hodza101/Maturski/viber_slika_2026-05-03_19-04-42-335.jpg

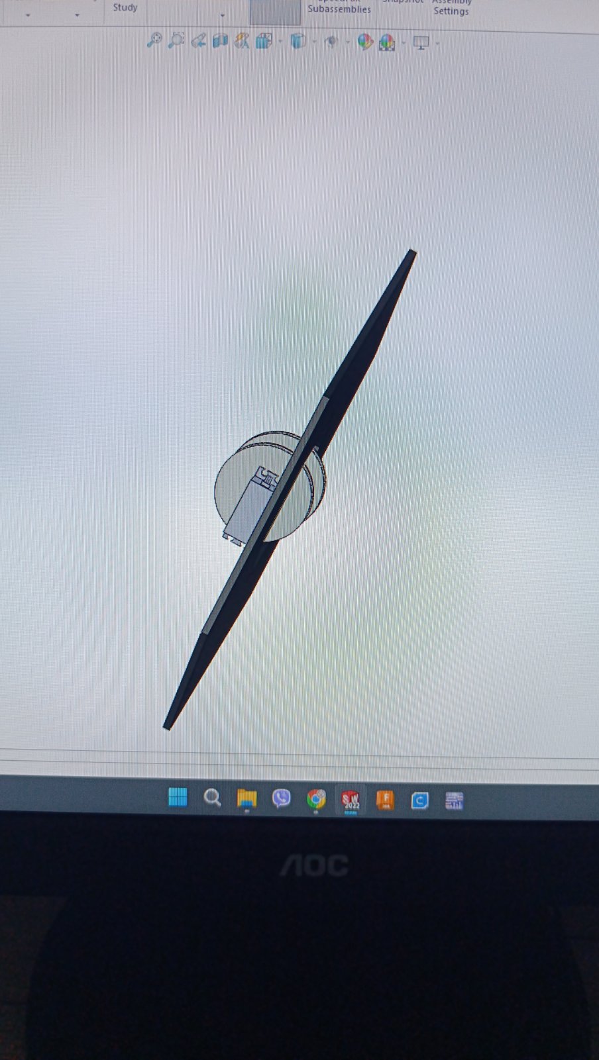
viber_slika_2026-05-03_19-04-42-335.jpg
