hodza101/Maturski/SpiRob_Grappler_Maturski_rad_v4_profesionalno.docx

JU MJEŠOVITA SREDNJA ELEKTROTEHNIČKA ŠKOLA TUZLA

MATURSKI RAD

Projektovanje i izrada modularnog kabelskog grapplera

sa šest fleksibilnih robotskih ruku

SpiRob Grappler — STM32 Mission Control

Predmet: | Maturski rad
Tema: | Projektovanje i izrada modularnog kabelskog grapplera sa šest fleksibilnih robotskih ruku
Učenici: | Edin Hodžić i Kenan Muhamedbegović
Mentor: | mr. sci. Muamer Halilović, dipl. ing. el.
Mjesto i datum: | Tuzla, maj 2026. godine

Radna dokumentacija sa hardverskim, softverskim i CAD/STL prilozima

# Sadržaj

# 1. Uvod

Maturski rad pod naslovom 'Projektovanje i izrada modularnog kabelskog grapplera sa šest fleksibilnih robotskih ruku' opisuje razvoj složenog mehatroničkog sistema koji objedinjuje mehaničko projektovanje, 3D/CAD modeliranje, elektroniku, ugrađeno programiranje, Bluetooth komunikaciju i razvoj korisničkih aplikacija. Upravljačka jedinica završne verzije sistema je mikrokontroler STM32F103C8T6, dok se za bežični prenos komandi koristi HC-06 Bluetooth modul.

Osnovna ideja projekta zasniva se na raspoređivanju šest fleksibilnih ruku oko heksagonalnog kućišta. Pokret svake ruke ostvaruje se povlačenjem sajli koje prolaze kroz kanale na platformama i navijaju se oko servo diskova. Ovakav kabelski pogon omogućava da motori budu smješteni na stabilnoj nosećoj platformi, dok se sila prenosi do krajeva ruku putem lakih i fleksibilnih sajli. Time se minimizuje masa pokretnih dijelova i bitno pojednostavljuje mehanička konstrukcija.

U dokumentaciji su obrađeni sljedeći aspekti: teorijska osnova i inspiracija iz naučne literature, izbor materijala i postupak konstruisanja, raspored rupa za sajle i opis CAD/STL rješenja, električno spajanje komponenti, komunikacioni protokol, STM32 upravljački program, desktop aplikacija app5.py, mobilna Android aplikacija, postupak instalacije i pokretanja, testiranje sistema, sigurnosne napomene i prijedlozi za buduća poboljšanja. Cilj je da dokumentacija bude dovoljno precizna i potpuna da se projekat može neovisno rekonstruisati, testirati i nadograditi.

# 2. Teorijska osnova i inspiracija iz literature

## 2.1. Logaritamska spirala i kabelski pogon

Inspiracija za ovaj projekat dolazi iz koncepta SpiRobs robotskih struktura, kod kojih se oblik i način kretanja zasnivaju na principu logaritamske spirale. U referentnoj literaturi navodi se da mnogi biološki nastavci — rep kameleona, rep morskog konjica, krak hobotnice i surla slona — ispoljavaju spiralne oblike koji omogućavaju hvatanje, obavijanje i manipulaciju objektima. Ovaj biološki princip prenosi se na robote tako što se tijelo gradi od modularnih segmenata sposobnih da se savijaju u spiralnu konfiguraciju.

Za potrebe ovog maturskog rada cilj nije bio matematički potpuno reproducirati sve modele iz literature, nego iskoristiti temeljni princip modularnog, kabelski pokretanog hvatača. U kabelskom pogonu motor rotira servo disk koji navija sajlu, a sajla prenosi silu do fleksibilne ruke izazivajući njeno savijanje. U praktičnoj primjeni ključni su faktori: minimizacija trenja u vodilicama, precizno poravnanje rupa za sajle te dovoljna mehanička čvrstoća nosača servo motora.

Odabir konfiguracije sa šest ruku zasniva se na nalazima iz literature koja pokazuje da višeručni raspored značajno povećava vjerovatnoću uspješnog obuhvatanja objekta sa više strana. Rezultati eksperimenata sa multi-SpiRob konfiguracijama pokazali su da šest ruku pruža visok postotak uspješnosti hvatanja u poređenju s konfiguracijama s manjim brojem ruku. Takav raspored je, dakle, i mehanički i funkcionalno opravdan.

## 2.2. Dopuna iz eksperimentalnih procedura

Dodatni materijali koji prate SpiRobs rad sadrže praktične smjernice vezane uz izradu prototipa. Tijelo robota preporučuje se štampati od TPU (termoplastičnog poliuretana) materijala. Pri tome treba pažljivo odabrati tvrdoću filamenta jer različite tvrdoće direktno utječu na krutost i elastičnost ruke. U navedenoj literaturi navodi se TPU 95A kao dobar kompromis između fleksibilnosti i pouzdane 3D štampe.

Posebno je istaknuto da TPU filament mora biti temeljno osušen prije štampe. Prisustvo vlage u filamentu uzrokuje pojavu tzv. stringa (neželjenih niti između dijelova), curenje materijala i neuredan prototip. Također se preporučuje izbjegavati sisteme s ekstruderom koji stvaraju visoko trenje pri dovodu materijala, te koristiti sisteme s direktnim dovodom filamenta kako bi se osigurao stabilan tok.

Za sajle se u literaturi preporučuje UHMWPE (ultra-high-molecular-weight polyethylene) sajla promjera oko 0,5 mm. Ovaj materijal je odabran zbog male mase, visoke čvrstoće i minimalnog istezanja pod opterećenjem. U ovom projektu ta vrsta sajle navedena je kao preporučeni izbor za buduću verziju rukavaca, dok su rupe na platformama predviđene s većim promjerom od 2 mm kako bi se osigurale tolerancija štampe i mogućnost ugradnje vodilica.

Tabela 1. Prenos preporuka iz literature na praktičnu izvedbu projekta.

Izvorna preporuka iz literature | Primjena u ovom projektu
TPU za fleksibilne dijelove | Fleksibilne ruke ili segmenti štampaju se od TPU filamenta.
TPU mora biti suh | Filament se temeljno suši prije štampe radi urednih rubova i stabilnog prototipa.
UHMWPE sajla ≈ 0,5 mm | Sajla za prenos sile; rupe na platformi iznose ø2 mm radi tolerancije.
Čelična žica kao igla za uvlačenje | Koristi se pri provlačenju sajle kroz duže ili uže kanale.
Kabelski pogon s 2–3 sajle po ruci | Svaka od šest ruku ima tri rupice za sajle raspoređene u obliku trougla.

# 3. Zahtjevi projekta

Projektni zahtjevi definirani su tokom višestrukih iteracija izrade prototipa te razvoja desktop i mobilne aplikacije. Prvobitno je sistem razmatran s pločom Arduino Uno, no završna verzija dokumentacije i koda prebačena je na STM32F103C8T6. Ova promjena je važna jer podrazumijeva novo mapiranje pinova, drugačije logičke nivoe (3,3 V umjesto 5 V), izmijenjeni naziv hardverske mape u aplikaciji i drugačiji postupak programiranja kontrolera.

Tabela 2. Sažetak osnovnih zahtjeva projekta.

Kategorija | Zahtjev
Mehanika | Heksagonalno kućište s donjom platformom, servo platformom i bočnim stranicama.
Broj ruku | Šest pozicija za ruke, ravnomjerno raspoređenih po heksagonu.
Rupe za sajle | Tri rupe po ruci, promjera 2 mm, raspoređene u obliku trougla.
Razmak platformi | Razmak između donje i srednje platforme iznosi 3 cm.
Aktuatori | Dva servo motora s čvrstim nosačima i servo diskovima.
Kontroler | STM32F103C8T6 — UART za Bluetooth, PWM za servo pogon.
Softver | Desktop aplikacija app5.py i Android aplikacija za mobilni telefon.
Sigurnost | E-STOP komanda mora uvijek biti lako dostupna i vidljiva u sučelju.

Pored funkcionalnih zahtjeva, važan kriterij je i prezentabilnost cjelokupnog sistema: aplikacija mora izgledati profesionalno, dokumentacija mora biti uredno formatirana, a dijagrami trebaju jasno i nedvosmisleno prikazati ono što je zaista projektovano i implementirano.

# 4. Mehanička konstrukcija i CAD/STL rješenje

Mehanička konstrukcija podijeljena je na tri glavna sklopa: Platforma 1 (donja noseća ploča), Platforma 2 (servo ploča) i bočne stranice. Platforma 1 nosi pozicije za šest ruku i otvore za prolaz sajli. Platforma 2 smješta nosače za dva servo motora i centralni otvor za upravljanje putanjama sajli. Bočne stranice spajaju obje platforme, daju kućištu krutost i štite unutrašnje komponente.

Slika 1. Pojednostavljena tehnička skica kućišta s dvije platforme i razmakom 3 cm između njih.

## 4.1. Platforma 1, Platforma 2 i bočne stranice

Na osnovu dostavljenih STL projekcija, donja ploča (Platforma 1) ima projektne dimenzije X = 195,8 mm, Z = 165,9 mm i debljinu oko 6 mm. Servo ploča (Platforma 2) ima dimenzije X = 153,5 mm, Z = 165,9 mm i debljinu oko 6 mm. Navedene vrijednosti služe kao referentne dokumentacione dimenzije i mogu se prilagoditi u CAD okruženju prema stvarnim tolerancijama štampe i dimenzijama dostupnih komponenti.

Bočne stranice imaju konstruktivnu ulogu: održavaju propisani razmak između platformi, štite unutrašnji elektronički sklop i sprečavaju uvijanje ploča pod opterećenjem. Preporučuje se da se bočne stranice štampaju s dovoljnim brojem perimetara (zidova), budući da sile nastale pri zatezanju sajli mogu biti prenijete na cijelo kućište.

## 4.2. Rupe za sajle i raspored šest ruku

Svaka od šest ruku ima tri kanala kroz koje prolaze sajle. Kanali su kružnog presjeka promjera 2 mm i raspoređeni su u obliku ravnostraničnog trougla. Takav raspored omogućava upravljanje savijanjem ruke u više smjerova i olakšava odvajanje i praćenje pojedinih sajli. S obzirom na to da postoji šest ruku, ukupan broj kanala za sajle na donjoj platformi iznosi 18.

Slika 2. Raspored šest pozicija za ruke i tri kanala za sajle po ruci (pogled odozgo).

Važno je da se isti raspored rupa rotira za 60° za svaku sljedeću poziciju ruke, čime se osigurava potpuna simetrija u odnosu na os heksagona. Nasumično raspoređene rupe rezultirale bi različitim kutovima prolaska sajli, povećanjem trenja i otežanom kalibracijom sistema.

Tabela 3. Mehaničke dimenzije i raspored otvora.

Element | Dimenzija / napomena
Platforma 1 (donja) | Pribl. X = 195,8 mm, Z = 165,9 mm, debljina 6 mm
Platforma 2 (servo) | Pribl. X = 153,5 mm, Z = 165,9 mm, debljina 6 mm
Kanali za sajle | ø 2 mm, 3 po ruci, ukupno 18 na platformi
Pozicije za ruke | Centralni otvor po poziciji prema CAD/STL modelu
Razmak platformi | 3 cm (30 mm)
Položaj servo diskova | Što bliže centralnom otvoru radi kraće i ravnije putanje sajle

# 5. Elektronika i napajanje

Elektronski sklop sistema čine četiri osnovna elementa: mikrokontroler STM32F103C8T6, Bluetooth modul HC-06, dva servo motora i zasebno napajanje servo pogona. STM32 prima komande iz aplikacije putem Bluetooth modula i pretvara ih u PWM (Pulse Width Modulation) signale za upravljanje servo motorima. Servo motori ne smiju se napajati direktno s mikrokontrolerske ploče jer pri opterećenju mogu povući znatno veću struju od stabilne izlazne struje STM32 ploče, što može uzrokovati resetovanje kontrolera ili trajno oštećenje regulatora napona.

Slika 3. Električna blok-shema spajanja STM32F103C8T6, HC-06 Bluetooth modula i servo pogona.

## 5.1. Prelazak sa Arduino Uno na STM32F103C8T6

Prelazak na STM32F103C8T6 donosi nekoliko tehničkih razlika u odnosu na Arduino Uno. Umjesto pinova D5/D6 za servo PWM i D10/D11 za softverski serijski port, koriste se pinovi PA0 i PA1 za PWM servo signale te PA9 i PA10 za hardverski UART1 koji komunicira s HC-06 modulom. Ključna razlika je u logičkim nivoima: STM32 koristi 3,3 V logiku, dok HC-06 modul na RXD pinu može primati 3,3 V signal direktno bez naponskog djelitelja — ali TX pin HC-06 generira 3,3 V, što je kompatibilno s STM32 RX ulazom.

## 5.2. Spajanje HC-06 modula i servo pogona

Tabela 4. Pin mapa za STM32F103C8T6.

STM32 pin | Spaja se na | Namjena
PA9 | HC-06 RXD | UART1 TX — slanje komandi prema Bluetooth modulu
PA10 | HC-06 TXD | UART1 RX — prijem odgovora iz Bluetooth modula
PA0 | Signal servo 1 | PWM izlaz za prvi servo motor
PA1 | Signal servo 2 | PWM izlaz za drugi servo motor
GND | GND (HC-06 + napajanje serva) | Zajednička masa cijelog sistema
5V / USB | Napajanje STM32 ploče | Napajanje upravljačke elektronike

Vanjsko napajanje servo motora treba biti u rasponu od 5 V do 6 V, ovisno o tipu servo motora. Za pouzdano napajanje dva servo motora preporučuje se izvor struje od najmanje 2 A. Najvažnije pravilo koje mora biti ispunjeno: GND vanjskog napajanja mora biti fizički spojen na GND pin STM32 ploče. Bez zajedničke reference mase, PWM signal koji generira STM32 nema stabilnu referentnu točku i servo motor može trzati, davati neispravne odgovore ili uopće ne reagovati na komande.

# 6. Komunikacioni protokol

Radi stabilnosti bežične veze uveden je protokol koji se oslanja na okvire poruka. Umjesto da aplikacija šalje pojedinačne znakove, svaka komanda se omata između znakova < i >. Primjeri: <g> za naredbu hvatanja, <f> za E-STOP / otpuštanje, <A090> za postavljanje servo 1 na kut od 90°. STM32 čita cijelu poruku unutar okvira, parsira je i vraća potvrdu izvršavanja.

Ovakav protokol je robusniji od protokola bez okvira jer osigurava da djelimično primljene poruke (uslijed Bluetooth latencije ili buke) ne budu pogrešno interpretirane kao validne komande. Tek po prepoznavanju znaka > smatra se da je poruka kompletna i pristupa se obradi.

Slika 4. Tok komunikacionog protokola između aplikacije, HC-06 modula i STM32 kontrolera.

Tabela 5. Skup komandi komunikacionog protokola.

Komanda | Značenje | Primjer odgovora STM32
<g> | Uhvati (zatvori hvatač) | ACK:g + STATE:S1=5;S2=175;GRIP=100
<f> | E-STOP / Pusti (sigurno stanje) | ACK:f + povratak u sigurni položaj
<h> | Home položaj | ACK:h + početni uglovi serva
<o> | Otvori | ACK:o
<c> | Zategni | ACK:c
<1> | Test servo 1 | ACK:1
<2> | Test servo 2 | ACK:2
<?> | Ping / provjera veze | ACK:? + STATE poruka
<A090> | Servo 1 → 90° | ACK:A090
<B120> | Servo 2 → 120° | ACK:B120

ACK poruka potvrđuje da je kontroler primio i razumio komandu. STATE poruka opisuje trenutno stanje serva i procijenjeni postotak hvata (GRIP). Time se izbjegava situacija u kojoj aplikacija prikaže promijenjeno stanje, a kontroler komandu zapravo nije izvršio — što bi u mehaničkom sistemu moglo dovesti do nepredviđenih kretnji.

# 7. STM32 upravljački program

STM32 program napisan je u Arduino/STM32duino stilu kako bi se olakšala izrada i upload koda putem Arduino IDE okruženja. Program prima serijske podatke putem UART-a, prepoznaje poruke omeđene znakovima < i >, izvršava odgovarajuću komandu i šalje ACK/STATE potvrde natrag prema aplikaciji.

Glavni zadaci programa su sljedeći: inicijalizacija UART komunikacije na 9600 baud, inicijalizacija PWM signala za dva servo motora, parsiranje dolaznih poruka, ograničavanje kuta servo motora na dozvoljeni raspon (0°–180°), slanje potvrda i vraćanje sistema u sigurni položaj pri izvršavanju E-STOP komande.

Isječak koda — inicijalizacija i pomoćne funkcije (kod_stm.ino):

#include <Arduino.h>

#include <Servo.h>

#define BT Serial1

const uint8_t SERVO1_PIN = PA0;

const uint8_t SERVO2_PIN = PA1;

const int SERVO1_HOME = 175;

const int SERVO2_HOME = 5;

const int SERVO1_PULL = 5;

const int SERVO2_PULL = 175;

const int SERVO_MIN = 0;

const int SERVO_MAX = 180;

const int STEP_DELAY_MS = 8;

const bool DETACH_AFTER_MOVE = false;

Servo servo1, servo2;

int s1 = SERVO1_HOME, s2 = SERVO2_HOME;

bool frameOpen = false;

String frame = "";

void attachServos() {

if (!servo1.attached()) servo1.attach(SERVO1_PIN);

if (!servo2.attached()) servo2.attach(SERVO2_PIN);

}

int clampAngle(int v) {

return (v < SERVO_MIN) ? SERVO_MIN : (v > SERVO_MAX) ? SERVO_MAX : v;

}

int gripPercent() {

float p1 = constrain(float(SERVO1_HOME - s1) / float(SERVO1_HOME - SERVO1_PULL), 0.f, 1.f);

float p2 = constrain(float(s2 - SERVO2_HOME) / float(SERVO2_PULL - SERVO2_HOME), 0.f, 1.f);

return int((p1 + p2) * 50.f + 0.5f);

}

void sendLine(const String &msg) { BT.println(msg); Serial.println(msg); }

void sendState() {

sendLine("STATE:S1=" + String(s1) + ";S2=" + String(s2)

+ ";GRIP=" + String(gripPercent()) + ";MCU=STM32F103C8T6");

}

void ack(const String &cmd) { sendLine("ACK:" + cmd); sendState(); }

void err(const String &cmd) { sendLine("ERR:" + cmd); sendState(); }

Kompletni izvorni kod nalazi se u prilogu kod_stm.ino. U tijelu dokumentacije prikazan je samo reprezentativni isječak; cjeloviti fajl s funkcijama setup(), loop() i svim handlerama komandi priložen je uz elektronsku verziju rada.

# 8. Desktop aplikacija app5.py

Desktop aplikacija app5.py namijenjena je kao inženjerski kontrolni panel za razvoj, kalibraciju i demonstraciju sistema. Omogućava odabir COM porta, uspostavljanje veze s HC-06 modulom, slanje komandi, vizualni prikaz stanja hvatača (digitalni twin), podešavanje kutova servo motora klizačima te praćenje TX/RX logova u realnom vremenu.

Slika 5. Desktop aplikacija SpiRob Mission Control prilagođena za STM32F103C8T6 kontroler.

Tabela 6. Funkcionalni paneli desktop aplikacije.

Panel aplikacije | Opis funkcionalnosti
Konekcija | Automatski pronalazak dostupnih COM portova i uspostavljanje veze s HC-06 modulom.
Hardver mapa | Vizualni prikaz rasporeda pinova STM32 (PA9/PA10 za UART, PA0/PA1 za PWM).
Upravljanje | Slanje glavnih komandi: UHVATI, E-STOP, HOME, OTVORI, ZATEGNI, TEST.
Digital Twin | Animirani prikaz očekivanog položaja hvatača na osnovu primljenih STATE vrijednosti.
Kalibracija | Klizači za precizno podešavanje kutova servo 1 i servo 2.
Napredni log | Praćenje svih TX/RX poruka s vremenskim oznakama i opcijom izvoza u JSON.

Aplikacija koristi protokol s okvirima, pa se svaka komanda prije slanja automatski formatira u odgovarajući format (<g>, <f>, <A090> i sl.). U TX/RX logu se prikazuje točno što je aplikacija poslala i što je STM32 vratio. Ukoliko nema ACK odgovora, preporučuje se provjera ispravnosti COM porta, status uparivanja HC-06 modula u Bluetooth postavkama operativnog sistema te ispravnost napajanja kontrolera.

# 9. Mobilna aplikacija

Mobilna aplikacija razvijena je u programskom jeziku Kotlin korištenjem Jetpack Compose UI okvira za Android platformu. Aplikacija komunicira s HC-06 modulom putem Bluetooth SPP (Serial Port Profile) protokola i šalje identičan skup komandi kao desktop aplikacija. Prednost mobilnog rješenja je praktičnost tokom demonstracije — telefon može biti potpuno odvojen od laptopa, a operator može upravljati sistemom s veće udaljenosti ili iz drugog kuta.

U aplikaciju je integriran Smart Voice Assistant. Kada korisnik izgovori komandu poput 'uhvati' ili 'provjeri stanje', aplikacija provodi prepoznavanje govora, predlaže odgovarajuću komandu u tekstu i zahtijeva eksplicitnu potvrdu pritiskom na dugme POTVRDI. Ovakav dvostepeni pristup je sigurniji od direktnog izvršavanja glasovnih komandi, jer sprečava slučajno aktiviranje servo motora uslijed pogrešno prepoznate ili djelimično čuvene govorne komande.

Tabela 7. Funkcije mobilne aplikacije.

Element | Opis
Bluetooth lista | Prikaz uparenih uređaja i odabir HC-06 modula za uspostavu veze.
Manual controls | Dugmad: UHVATI, E-STOP, HOME, OTVORI, ZATEGNI, TEST i PING.
Smart Voice Assistant | Prepoznavanje govora s prijedlogom komande; izvršavanje tek nakon potvrde.
Quick metrics | Statusni pregled: stanje veze, zadnja komanda, RX poruka i grip intenzitet.
Calibration | Klizači za ručno podešavanje kutova servo motora s telefona.
Log | Praćenje toka komunikacije s vremenskim oznakama direktno na ekranu telefona.

Datoteka AndroidManifest_STM32.xml sadrži sve Bluetooth dozvole potrebne za novije verzije Android operativnog sistema (Android 12+). Izvorni kod aplikacije nalazi se u fajlu nova_app_tel.kt. Prije prvog testiranja potrebno je upariti HC-06 modul u Bluetooth postavkama telefona i odobriti sve tražene dozvole pri instalaciji.

# 10. Instalacija softvera i razvojna okruženja

Za rad na projektu na novom računaru potrebno je instalirati sljedeće alate: Arduino IDE za upload STM32 koda, Android Studio za build i instalaciju Android aplikacije, Git for Windows za verzionisanje koda, Python za pokretanje desktop aplikacije i, po potrebi, Samsung USB Driver za USB debugging na Samsung uređajima. Za prikazivanje Android ekrana na računaru može se koristiti aplikacija scrcpy (otvoreni kôd) ili AnyDesk.

Tabela 8. Softverski preduvjeti za rad na projektu.

Program | Svrha | Službeni izvor
Arduino IDE | Upload STM32/STM32duino koda | https://www.arduino.cc/en/software
Android Studio | Build i instalacija Android aplikacije | https://developer.android.com/studio
Git for Windows | Verzionisanje projekta na GitHubu | https://git-scm.com/download/win
Python | Pokretanje desktop aplikacije | https://www.python.org/downloads/
Samsung USB Driver | USB debugging za Samsung uređaje | https://developer.samsung.com/android-usb-driver
scrcpy | Prikaz Android ekrana na PC-u | https://github.com/Genymobile/scrcpy
AnyDesk | Alternativni udaljeni prikaz ekrana | https://anydesk.com/

PowerShell — pokretanje desktop aplikacije:

cd C:\putanja\do\projekta

python -m venv .venv

.\.venv\Scripts\activate

pip install -r requirements_desktop.txt

python app5.py

Git — inicijalno postavljanje repozitorija na GitHub:

git init

git add .

git commit -m "Initial STM32 grappler project"

git branch -M main

git remote add origin https://github.com/USERNAME/REPO_NAME.git

git push -u origin main

# 11. Testiranje i verifikacija sistema

Testiranje se provodi postepeno, od jednostavnih provjera prema kompleksnim scenarijima. Najpre se provjerava ispravan upload koda i reakcija STM32 bez priključenih sajli, zatim komunikacija putem HC-06 modula, potom pojedinačna kretnja servo motora, a tek na kraju kompletna mehanička konfiguracija sa sajlama. Ovakav redoslijed minimizira rizik od trzanja, pucanja sajle, preopterećenja nosača servo motora ili neželjenog resetovanja kontrolera.

Tabela 9. Predloženi redoslijed koraka testiranja.

Korak | Radnja | Očekivani rezultat
1 | Upload kod_stm.ino na STM32 | Kontroler pokreće UART i inicijalizira servo motore.
2 | Slanje komande <?> | STM32 vraća ACK:? i STATE poruku s trenutnim stanjem.
3 | Slanje komande <1> | Servo 1 izvodi testni pokret u opsegu kalibracije.
4 | Slanje komande <2> | Servo 2 izvodi testni pokret u opsegu kalibracije.
5 | Slanje komande <h> | Oba serva se vraćaju u definirani home položaj.
6 | Spajanje desktop aplikacije | TX/RX log prikazuje ispravne poruke bez grešaka.
7 | Spajanje mobilne aplikacije | Telefon uspješno šalje komande i prima STATE potvrde.
8 | Test sa sajlama | Ruke se pomjeraju bez zaglavljivanja i pretjeranog trenja.

Ukoliko servo ne reaguje na komande, kao prvi korak treba provjeriti napajanje servo motora i zajednički GND. Ako aplikacija šalje komande, ali nema ACK odgovora, treba provjeriti ispravan COM port u aplikaciji, baud rate (9600), te pravilno spajanje PA9/PA10 sa HC-06 modulom.

# 12. Sigurnosne napomene

E-STOP (nužno zaustavljanje) komanda mora biti lako dostupna i vidno istaknuta i u desktop i u mobilnoj aplikaciji. Tokom testiranja nije preporučljivo zadržavati prste ili ruke u zoni kretanja robotskih ruku ili putanja sajli. Servo motori mogu neočekivano krenuti ako se pošalje pogrešna komanda, ako se aplikacija ponovo poveže nakon prekida, ili ako dođe do naponske smetnje u napajanju.

Servo motori ne smiju se napajati s 9 V baterije: standardni servo motor radi u rasponu 5 V – 6 V, a 9 V baterija uglavnom ne može isporučiti dovoljnu struju za dva motora pod opterećenjem, što uzrokuje pad napona i neispravan rad. Za testiranje se preporučuje USB napajanje za STM32 ploču i zasebno stabilizovano 5 V/6 V napajanje (min. 2 A) za servo motore, uz obavezno spajanje GND linija.

Tabela 10. Identifikovani rizici i mjere zaštite.

Rizik | Mjera zaštite
Pad napona pri pokretanju serva | Zasebno napajanje servo motora, minimalno 2 A.
Pogrešna komanda putem Bluetootha | ACK/STATE protokol s potvrdom i istaknuto E-STOP dugme.
Mehaničko zaglavljivanje sajle | Postepeno testiranje bez opterećenja i vizuelna provjera svih kanala.
Pregrijavanje servo motora | Ne zadržavati servo dugo u blokiranom ili krajnjem položaju.
Loš GND spoj | Zajednička fizička masa za STM32, HC-06 i napajanje servo motora.

# 13. Moguća poboljšanja i daljnji razvoj

Daljnji razvoj sistema može ići u nekoliko smjerova koji se prirodno nadovezuju na postignuto. Prva i najkorisnija nadogradnja bila bi ugradnja mjerenja struje servo motora: porast struje pri opterećenju može poslužiti kao jednostavan indikator kontakta s objektom, što bi u budućoj verziji omogućilo određeni stupanj automatskog hvatanja bez eksplicitne komande operatera.

Druga nadogradnja odnosi se na poboljšanje prikaza digitalnog twina: stanje bi se trebalo ažurirati isključivo na temelju primljene STATE poruke s kontrolera, a ne odmah po akciji u sučelju aplikacije. Treća nadogradnja uključuje dodavanje više PWM kanala za nezavisno upravljanje pojedinim sajlama svake ruke, čime bi se postigla preciznija kontrola oblika savijanja.

Na mehaničkom planu moguća je izrada nove verzije kućišta s vodilicama za sajle, kugličnim ležajevima na servo diskovima i modularnim konektorima za brzu zamjenu oštećene ruke. Softverski se može dodati snimanje i reprodukcija makro sekvenci pokreta te automatski export logova nakon sesije radi kasnijeg vrednovanja i analize rada sistema.

# 14. Zaključak

U ovom maturskom radu prikazan je cjelovit razvoj modularnog kabelskog grapplera sa šest fleksibilnih robotskih ruku. Projekat uspješno spaja mehaničku konstrukciju, elektroniku i softver u jednu funkcionalnu mehatroničku cjelinu. Poseban doprinos rada ogleda se u prelasku na STM32F103C8T6 kontroler s jasno definiranom pin mapom, uvođenju standardiziranog komunikacionog protokola s potvrdama te razvoju profesionalnih desktop i mobilnih aplikacija za upravljanje.

Mehanička konstrukcija koristi dvije platforme, bočne stranice i šest pozicija za ruke sa po tri kanala za sajle. Elektronski sklop koristi HC-06 Bluetooth modul za bežičnu komunikaciju, dva servo motora i zasebno stabilizovano napajanje servo pogona. ACK/STATE protokol osigurava pouzdaniju i verifikabilnu komunikaciju između upravljačke aplikacije i mikrokontrolera.

Projekat predstavlja solidnu osnovu za daljnji razvoj u pravcu napredne robotike: mogu se dodati senzori sile i struje, preciznija regulacija pokreta, napredniji matematički modeli savijanja i automatske sekvence hvatanja. U edukativnom kontekstu, rad se može koristiti kao demonstracija principa mehatronike, ugrađenih sistema, Bluetooth komunikacije i CAD/3D štampe u jednom integrisanom projektu.

# 15. Literatura

[1] Wang, Z., Freris, N. M., Wei, X. SpiRobs: Logarithmic spiral-shaped robots for versatile grasping across scales. Device, 2025.

[2] Wang, Z., Freris, N. M., Wei, X. Supplemental information: SpiRobs fabrication instructions and supplemental experimental procedures. Device, 2025.

[3] JU Mješovita srednja elektrotehnička škola Tuzla. Uputstvo za izradu pismenog dijela maturskog rada.

[4] STMicroelectronics. STM32F103C8T6 Reference Manual i Datasheet dokumentacija. Dostupno: https://www.st.com

[5] Arduino. Arduino IDE preuzimanje i dokumentacija. Dostupno: https://www.arduino.cc/en/software

[6] Android Developers. Android Studio i Jetpack Compose dokumentacija. Dostupno: https://developer.android.com/studio

[7] Git SCM. Git for Windows. Dostupno: https://git-scm.com/download/win

[8] Python Software Foundation. Python Downloads. Dostupno: https://www.python.org/downloads/

[9] Projektni materijali: STL fajlovi, skice rasporeda rupa, screenshotovi aplikacije i izvorni kodovi izrađeni tokom izrade rada.

# 16. Prilozi

## 16.1. Elektronski paket projekta

Tabela 11. Struktura datoteka elektronskog paketa.

Datoteka / folder | Sadržaj i namjena
kod_stm.ino | STM32 upravljački program za HC-06 Bluetooth i dva servo motora.
app5.py | Desktop aplikacija za Windows — inženjerski kontrolni panel.
nova_app_tel.kt | Android/Kotlin mobilna aplikacija za upravljanje s telefona.
AndroidManifest_STM32.xml | Bluetooth dozvole za Android aplikaciju (Android 12+).
requirements_desktop.txt | Popis Python biblioteka potrebnih za desktop aplikaciju.
figures/ | Slike, dijagrami i screenshotovi korišteni u dokumentaciji.
docs/ | Word (.docx) i PDF verzija maturskog rada.

## 16.2. Isječak desktop aplikacije app5.py

Inicijalizacija, konstante i osnovna struktura klase GrapplerApp:

import json, threading, time

from datetime import datetime

from pathlib import Path

import customtkinter as ctk

import serial

from serial.tools import list_ports

BAUD = 9600

APP_TITLE = "SpiRob Grappler Mission Control"

CONFIG_PATH = Path("grappler_config.json")

LOG_EXPORT_PATH = Path("grappler_log_export.json")

ctk.set_appearance_mode("dark")

ctk.set_default_color_theme("blue")

COLORS = {

"bg": "#070b14",

"card": "#111827",

"blue": "#2563eb",

"red": "#ef4444",

"green": "#22c55e",

"muted": "#94a3b8",

}

class GrapplerApp(ctk.CTk):

def __init__(self):

super().__init__()

self.title(APP_TITLE)

self.geometry("1500x900")

self.minsize(1180, 760)

self.ser = None

self.connected = False

self.s1, self.s2, self.grip = 175, 5, 0

self.load_config()

self.build_ui()

self.refresh_ports()

self.after(1000, self.periodic_ui)

JU Mješovita srednja elektrotehnička škola Tuzla | Strana od

SpiRob Grappler — STM32 Mission Control | Maturski rad 2026.
