hodza101/Maturski/viber_slika_2026-05-03_11-28-47-099.jpg

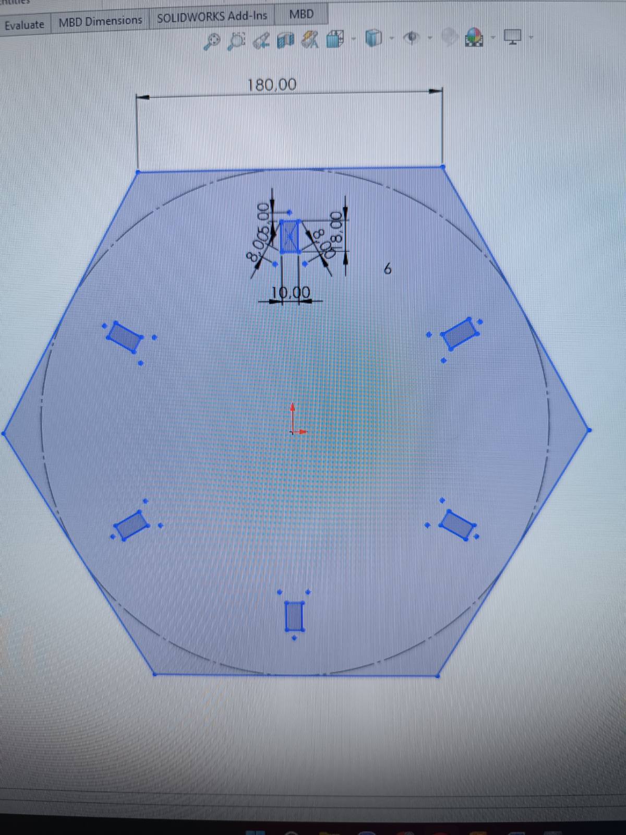
viber_slika_2026-05-03_11-28-47-099.jpg
