hodza101/Maturski/viber_slika_2026-05-03_12-16-06-598.jpg

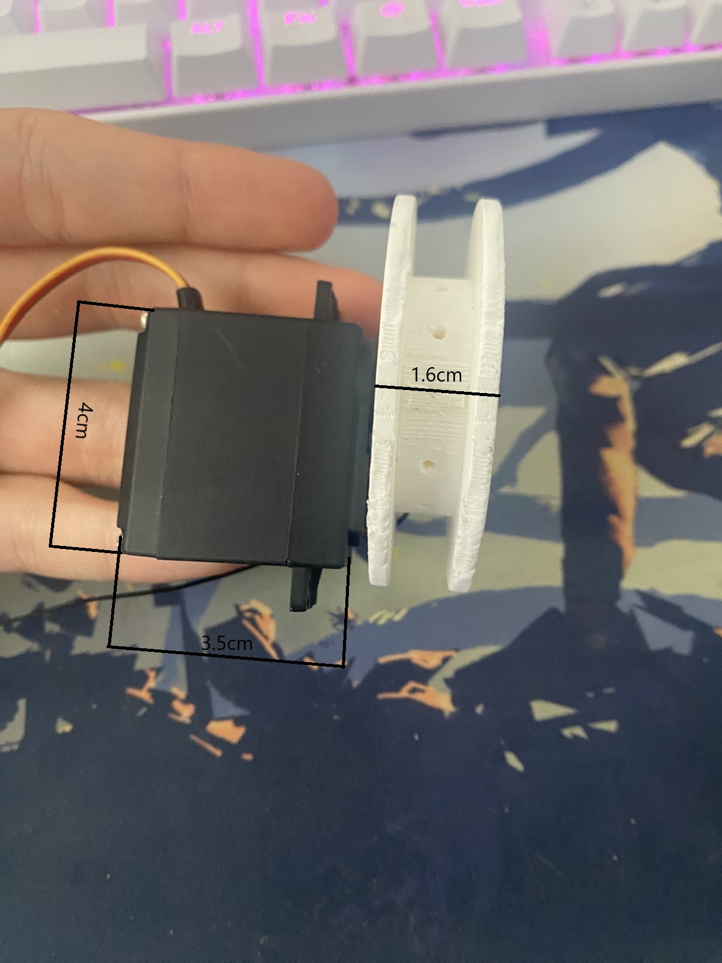
viber_slika_2026-05-03_12-16-06-598.jpg
