hodza101/Maturski/viber_slika_2026-05-03_12-21-53-807.jpg

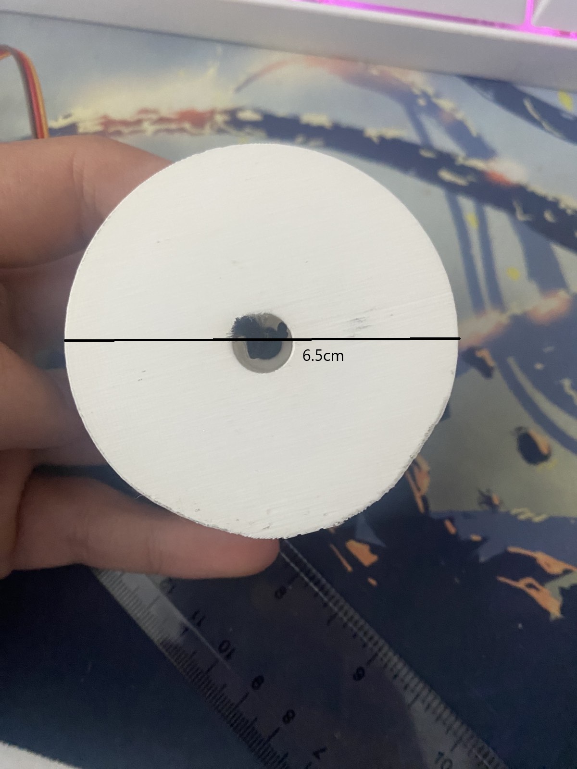
viber_slika_2026-05-03_12-21-53-807.jpg
