hodza101/Maturski/viber_slika_2026-05-03_18-59-29-752.jpg

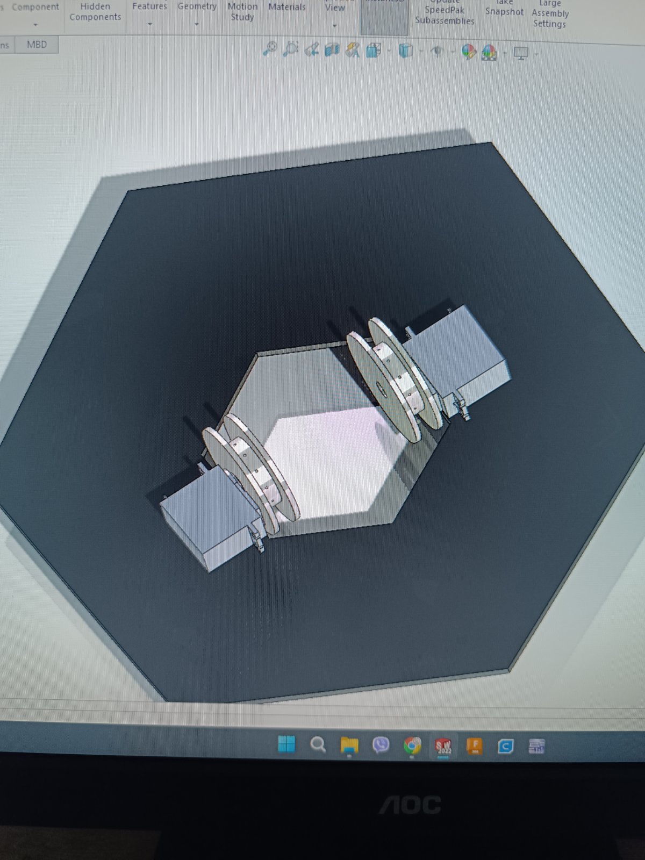
viber_slika_2026-05-03_18-59-29-752.jpg
